ZachEnglish/KarisBox/KarisGiftPCB/KarisGiftPCB_Front.jpg

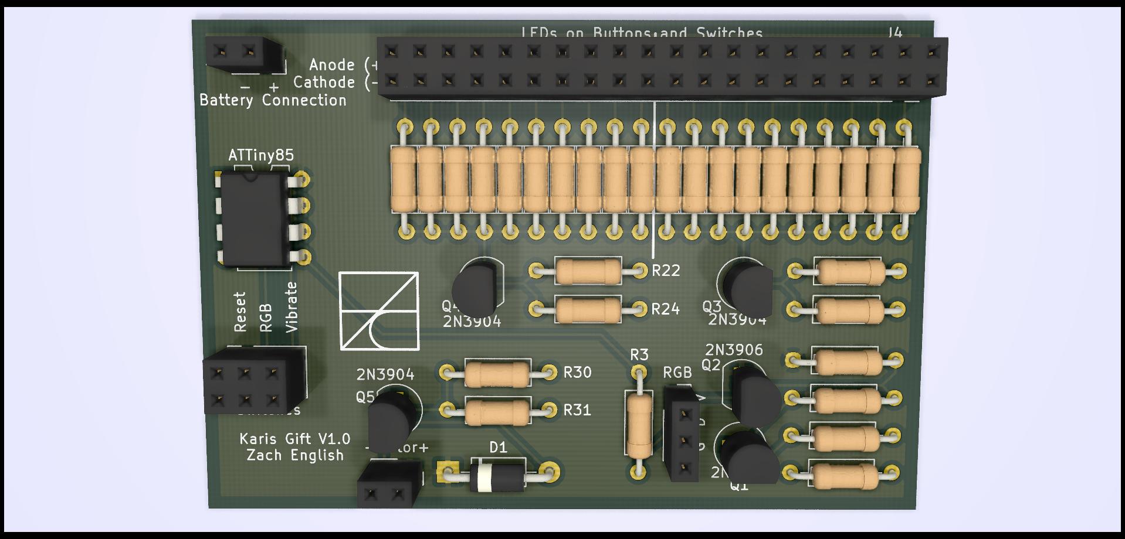
KarisGiftPCB/KarisGiftPCB_Front.jpg
