ZachEnglish/KarisBox/KarisGiftPCB/KarisGiftPCB_Back.jpg

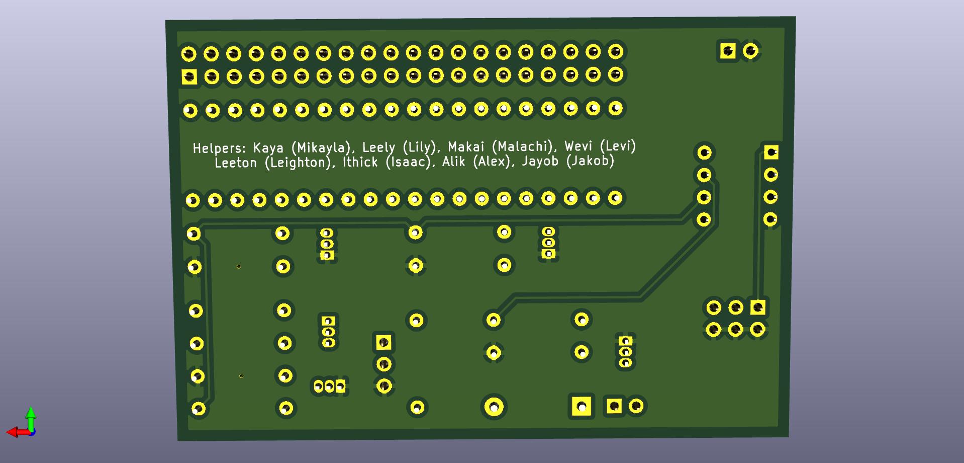
KarisGiftPCB/KarisGiftPCB_Back.jpg
