ZachEnglish/KarisBox/R_values_for_LEDs.docx

2.3k

420

420

2.0k

All at 3V without transistor drop.
