ZachEnglish/KarisBox/schematic.pdf

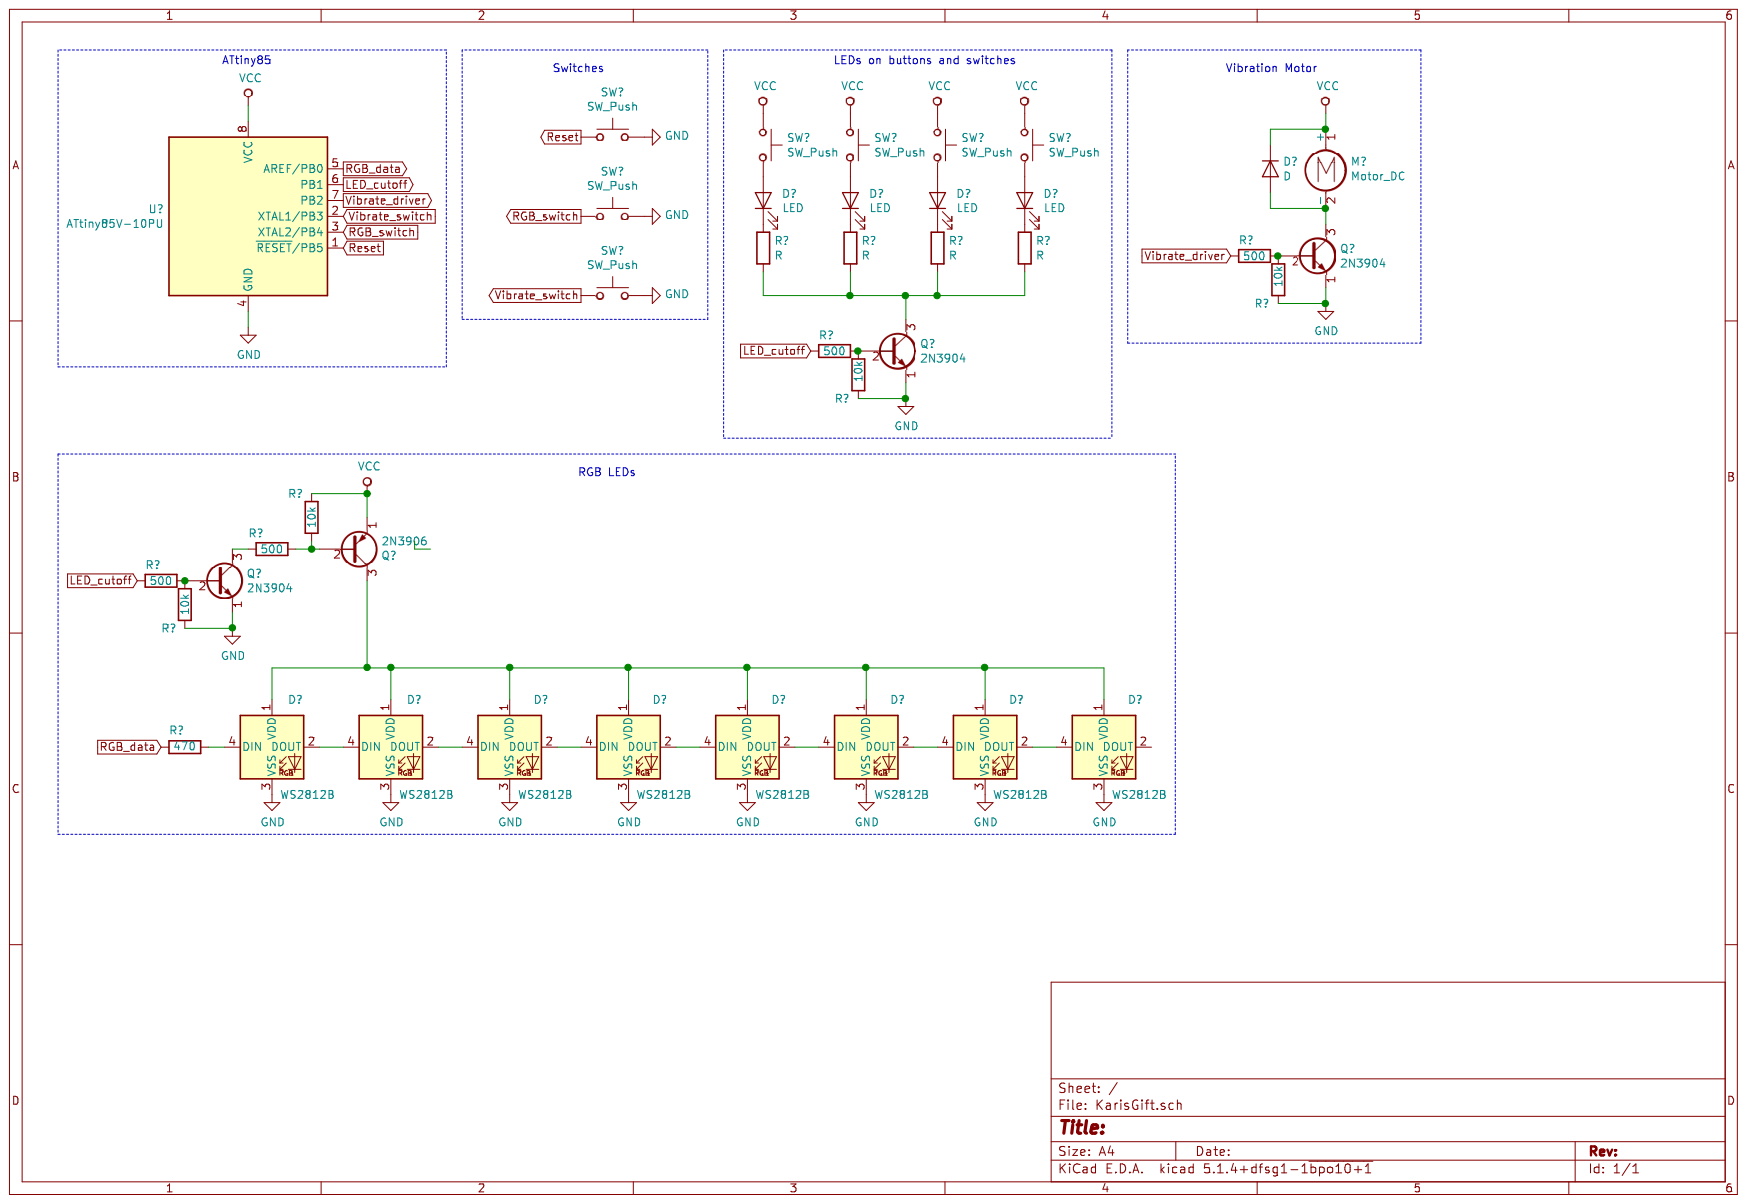
[picture p3: page 1]
