ZachEnglish/KarisBox/KarisGiftPCB/KarisGiftPCB_Schematic.pdf

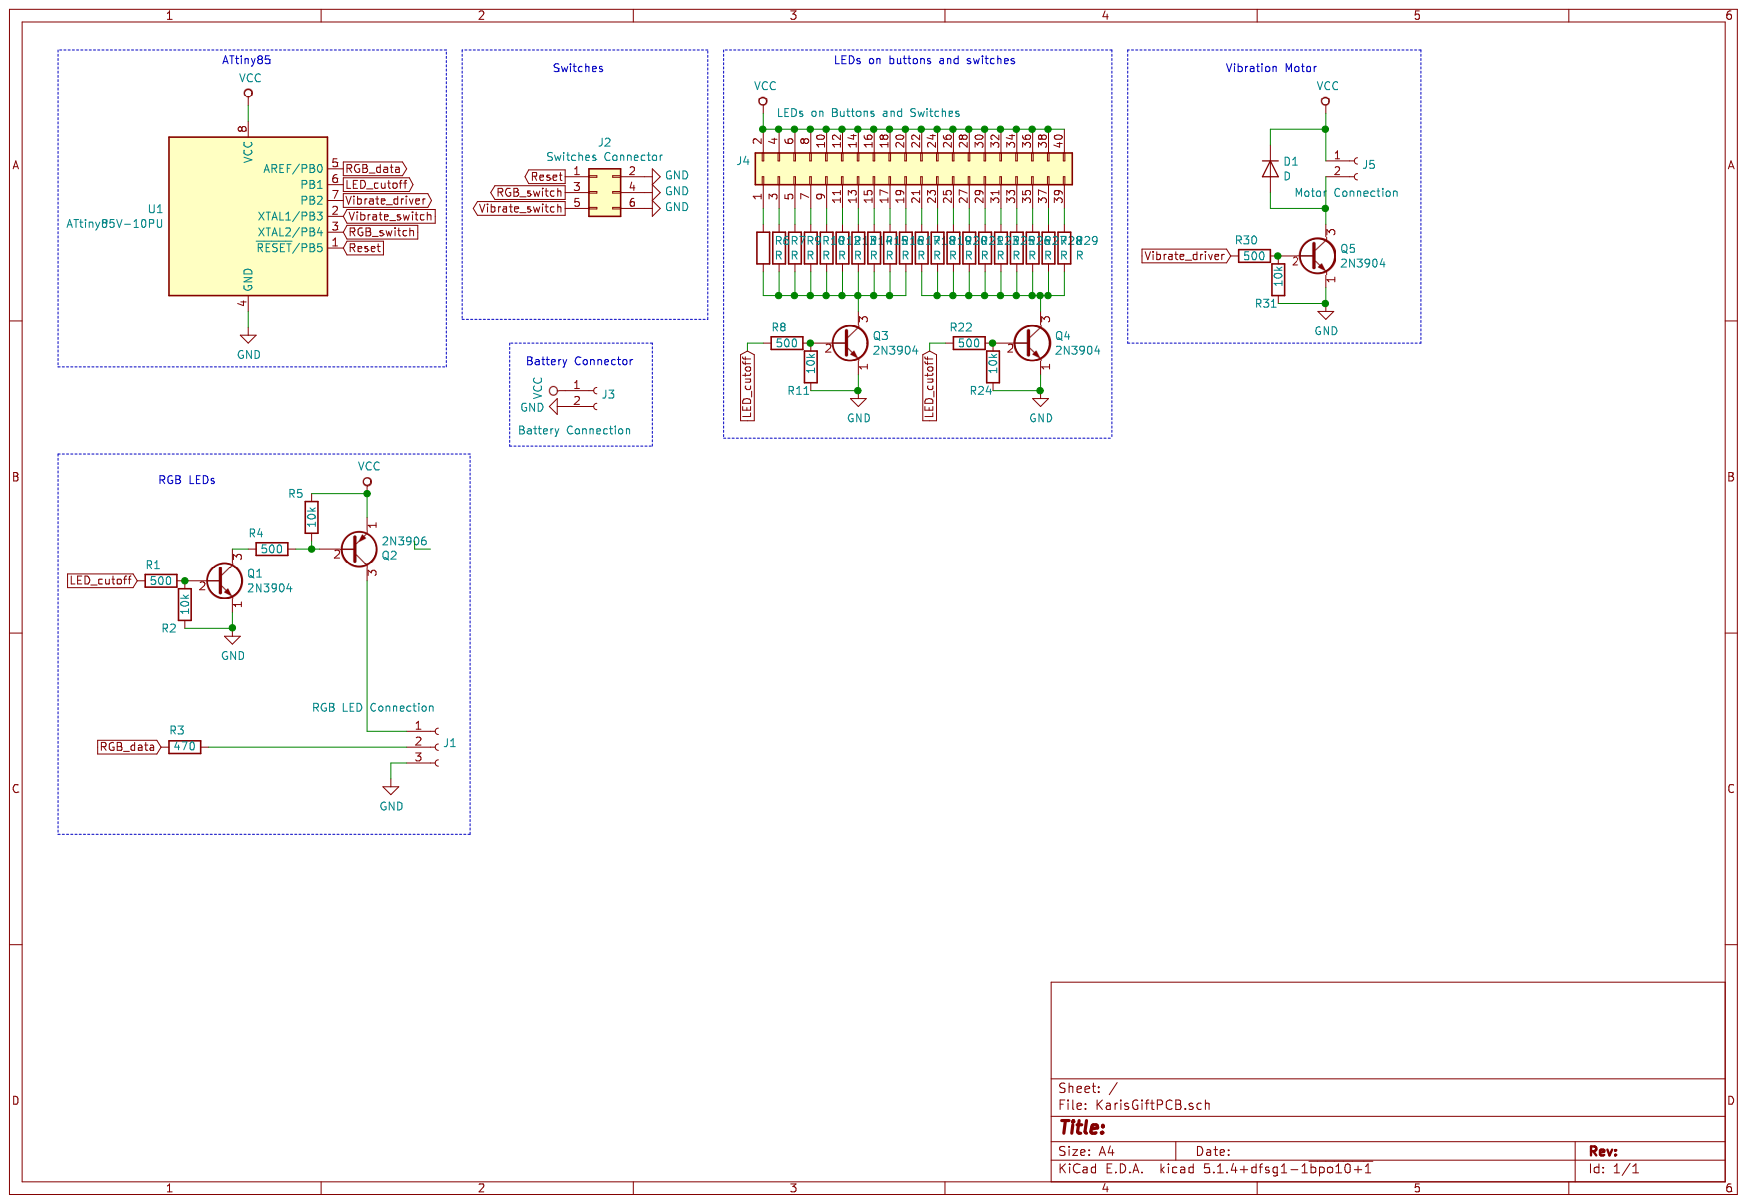
[picture p4: page 1]
