ZachEnglish/KarisBox/KarisGift.pdf

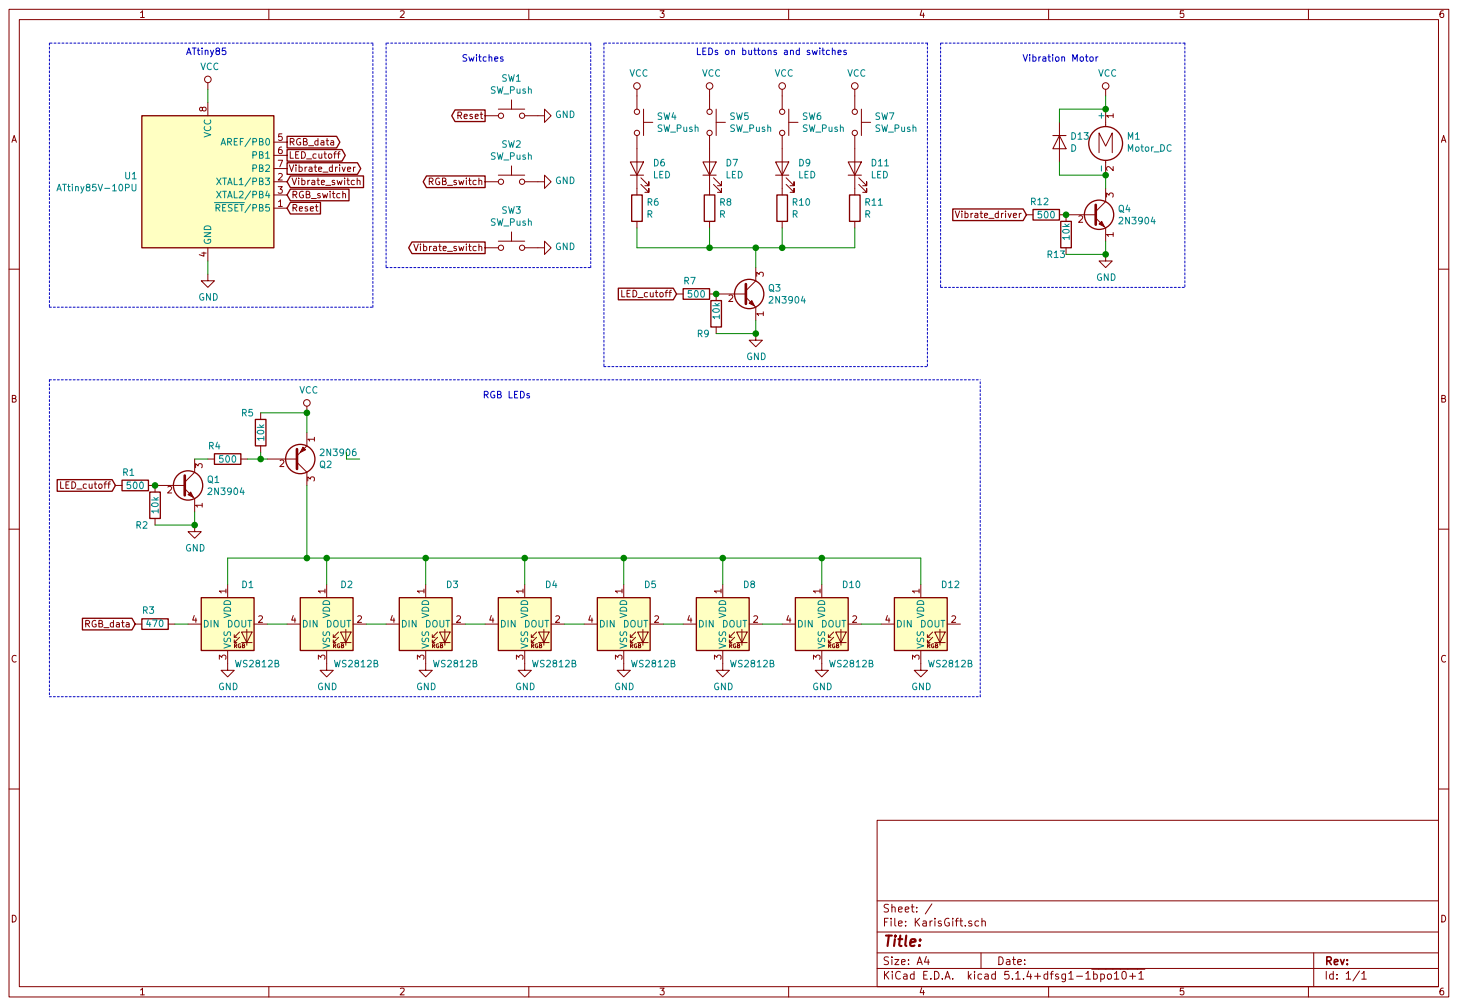
[picture p5: page 1]

Id: 1/1 Title: File: KarisGift.sch Sheet: /
