ZachEnglish/KarisBox/KarisGiftPCB/KarisGiftPCB.kicad_pcb

## KiCad design KarisGiftPCB/KarisGiftPCB.kicad_pcb (2021-02-07)

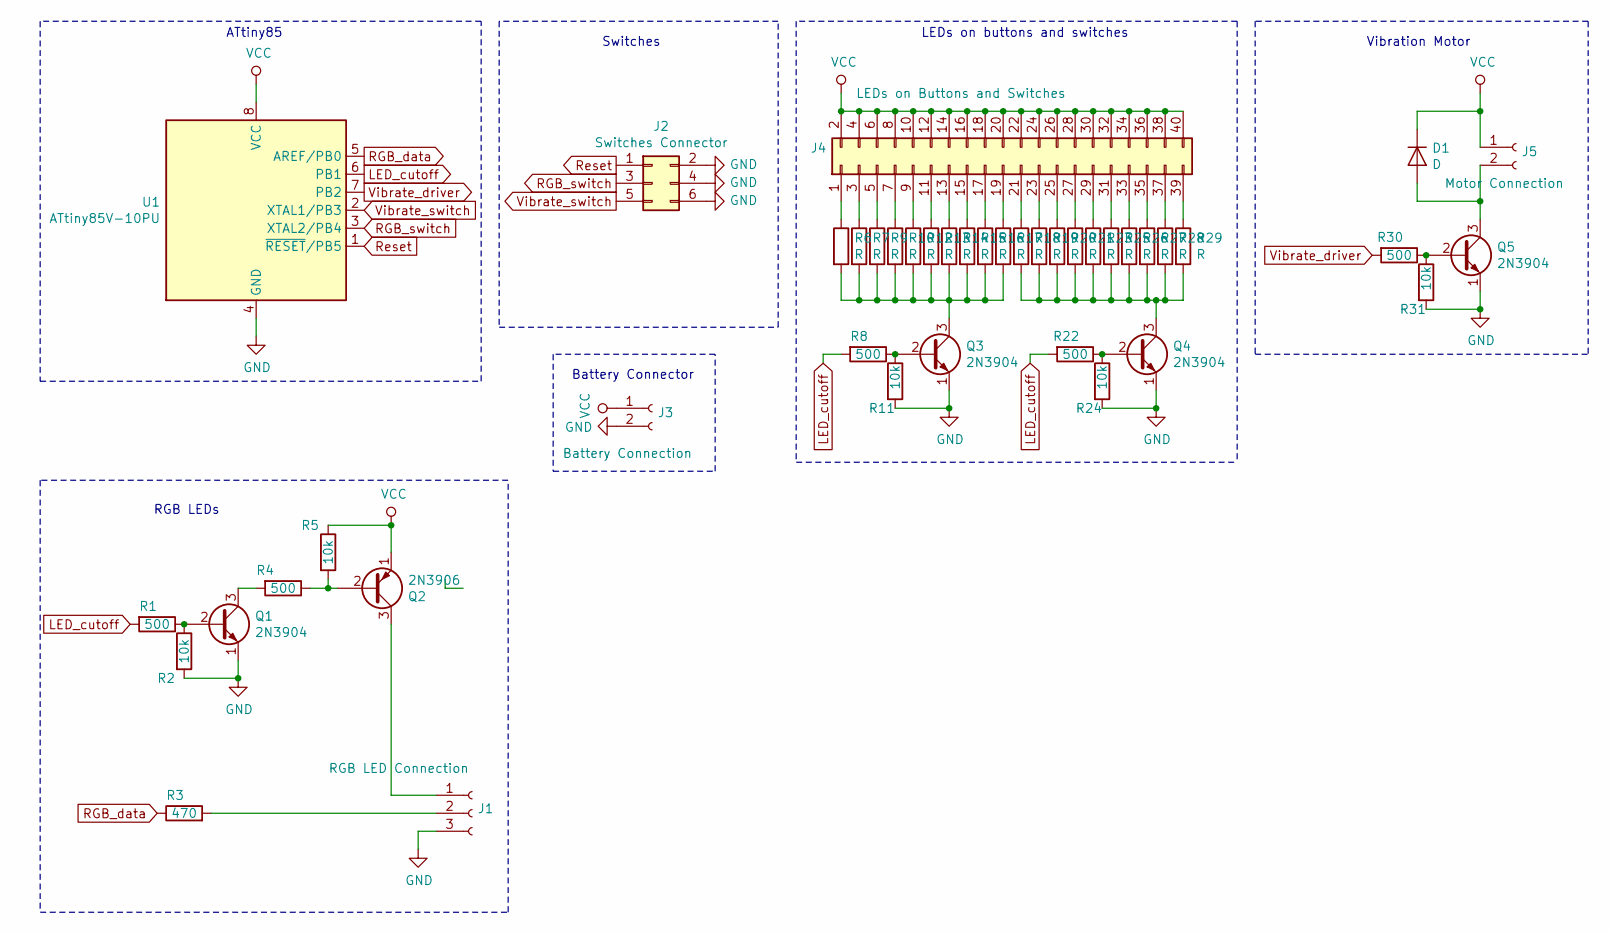
[picture p6: schematic KarisGiftPCB.sch]

Parts:
D1: D; D_DO-41_SOD81_P10.16mm_Horizontal
J1: RGB LED Connection; PinSocket_1x03_P2.54mm_Vertical
J2: Switches Connector; PinSocket_2x03_P2.54mm_Vertical
J3: Battery Connection; PinSocket_1x02_P2.54mm_Vertical
J4: LEDs on Buttons and Switches; PinSocket_2x20_P2.54mm_Vertical
J5: Motor Connection; PinSocket_1x02_P2.54mm_Vertical
Q1, Q3, Q4, Q5: 2N3904; TO-92_Inline
Q2: 2N3906; TO-92_Inline
R1, R4, R8, R22, R30: 500; R_Axial_DIN0207_L6.3mm_D2.5mm_P10.16mm_Horizontal
R2, R5, R11, R24, R31: 10k; R_Axial_DIN0207_L6.3mm_D2.5mm_P10.16mm_Horizontal
R3: 470; R_Axial_DIN0207_L6.3mm_D2.5mm_P10.16mm_Horizontal
R6, R7, R9, R10, R12, R13, R14, R15, R16, R17, R18, R19, R20, R21, R23, R25, R26, R27, R28, R29: R; R_Axial_DIN0207_L6.3mm_D2.5mm_P10.16mm_Horizontal
U1: ATtiny85V-10PU; DIP-8_W7.62mm

Connections:
GND: J1.3, J2.2, J2.4, J2.6, J3.2, Q1.1 (E), Q3.1 (E), Q4.1 (E), Q5.1 (E), R2.2, R11.2, R24.2, R31.2, U1.4 (GND); also elsewhere on the board
LED_cutoff: R1.2, R8.2, R22.2, U1.6 (PB1); also elsewhere on the board
unnamed 2: D1.2 (A), J5.2, Q5.3 (C); also elsewhere on the board
unnamed 3: J1.1, Q2.3 (C); also elsewhere on the board
unnamed 4: J1.2, R3.2; also elsewhere on the board
unnamed: J2.1, U1.1 (~RESET~/PB5)
unnamed: J2.3, U1.3 (XTAL2/PB4)
unnamed: J2.5, U1.2 (XTAL1/PB3)
unnamed: J4.1, R6.1
unnamed: J4.3, R7.1
unnamed: J4.5, R9.1
unnamed: J4.7, R10.1
unnamed: J4.9, R12.1
unnamed: J4.11, R13.1
unnamed: J4.13, R14.1
unnamed: J4.15, R15.1
unnamed: J4.17, R16.1
unnamed: J4.19, R17.1
unnamed: J4.21, R18.1
unnamed: J4.23, R19.1
unnamed: J4.25, R20.1
unnamed: J4.27, R21.1
unnamed: J4.29, R23.1
unnamed: J4.31, R25.1
unnamed: J4.33, R26.1
unnamed: J4.35, R27.1
unnamed: J4.37, R28.1
unnamed: J4.39, R29.1
unnamed: Q1.2 (B), R1.1, R2.1
unnamed: Q1.3 (C), R4.2
unnamed: Q2.2 (B), R4.1, R5.2
unnamed: Q3.2 (B), R8.1, R11.1
unnamed: Q3.3 (C), R6.2, R7.2, R9.2, R10.2, R12.2, R13.2, R14.2, R15.2, R16.2, R17.2
unnamed: Q4.2 (B), R22.1, R24.1
unnamed: Q4.3 (C), R18.2, R19.2, R20.2, R21.2, R23.2, R25.2, R26.2, R27.2, R28.2, R29.2
unnamed: Q5.2 (B), R30.1, R31.1
RGB_data: R3.1, U1.5 (AREF/PB0); also elsewhere on the board
VCC: D1.1 (K), J3.1, J4.2, J4.4, J4.6, J4.8, J4.10, J4.12, J4.14, J4.16, J4.18, J4.20, J4.22, J4.24, J4.26, J4.28, J4.30, J4.32, J4.34, J4.36, J4.38, J4.40, J5.1, Q2.1 (E), R5.1, U1.8 (VCC); also elsewhere on the board
Vibrate_driver: R30.2, U1.7 (PB2); also elsewhere on the board

Notes on the sheet:
ATtiny85
Switches
LEDs on buttons and switches
Vibration Motor
RGB LEDs
Battery Connector

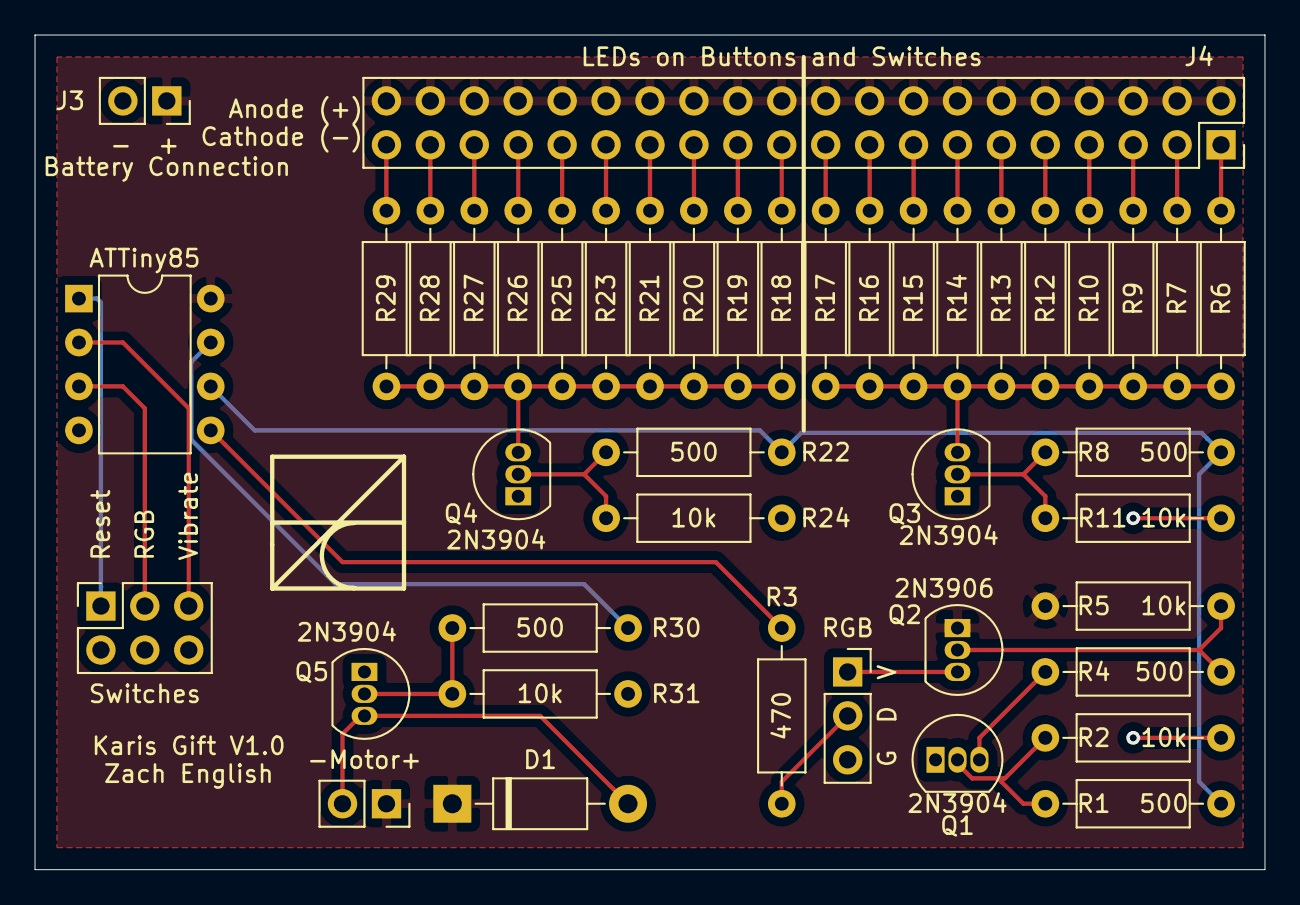
[picture p7: board KarisGiftPCB.kicad_pcb from above]

Board: 2 copper layers, 71.1 x 48.3 mm, 43 parts (0 on the bottom side), 39 nets.

Other parts of the board:
-Motor+: Motor Connection; PinSocket_1x02_P2.54mm_Vertical
ATTiny85: ATtiny85V-10PU; DIP-8_W7.62mm
RGB: RGB LED Connection; PinSocket_1x03_P2.54mm_Vertical
Switches: Switches; PinSocket_2x03_P2.54mm_Vertical

Their connections:
GND: ATTiny85.4, RGB.3, Switches.2, Switches.4, Switches.6; also elsewhere on the board
LED_cutoff: ATTiny85.6; also elsewhere on the board
unnamed 2: -Motor+.2; also elsewhere on the board
unnamed 3: RGB.1; also elsewhere on the board
unnamed 4: RGB.2; also elsewhere on the board
RGB_data: ATTiny85.5; also elsewhere on the board
RGB_switch: ATTiny85.3, Switches.3
Reset: ATTiny85.1, Switches.1
VCC: -Motor+.1, ATTiny85.8; also elsewhere on the board
Vibrate_driver: ATTiny85.7; also elsewhere on the board
Vibrate_switch: ATTiny85.2, Switches.5
