ZachEnglish/KarisBox/(commit log)

2021-01-08 Initial commit. Work in progress, need to update some transitors to PNP's.
    [KarisGift.kicad_pcb, KarisGift.sch]
2021-01-09 Updated RGB LEDs block to not move ground reference on data signal.
    Added pull up/down resisters for transistors.
    [KarisGift.sch]
2021-01-09 Added word file with R values for resistors.
2021-01-11 I can't believe it works! The code works!
    [KarisGift.sch]
2021-01-12 Updated schematic to use just one PNP transistor for RGB LEDs.
    Started the long process of cleaning up the code.
    [KarisGift.sch]
2021-01-12 Fixed backwards PNP transistor running the RGB LEDs (Thanks Ron!)
    Some more code cleanup.
    [KarisGift.sch]
2021-01-12 Mirrored PNP to make schematic less ugly
    [KarisGift.sch]
2021-01-13 Added second schematic in prep for layout. Replaced parts with jumpers.
    [KarisGiftPCB.sch]
2021-01-13 Added footprints to all parts in schematic.
    [KarisGift.sch, KarisGiftPCB.sch]
2021-01-13 Made new Kicad project for PCB schematic and layout. Started layout.
    [KarisGiftPCB.kicad_pcb, KarisGiftPCB.sch]
2021-01-13 Made some progress on PCB layout. "Some" as in, kinda started.
    [KarisGiftPCB.kicad_pcb, KarisGiftPCB.sch]
2021-01-14 Layout mostly done, just need wires, copper areas, and edge cuts.
    [KarisGiftPCB.kicad_pcb, KarisGiftPCB.sch]
2021-01-14 Finished board layout. Generated Gerber files.
    [KarisGiftPCB-B_Cu.gbr, KarisGiftPCB-B_Mask.gbr, KarisGiftPCB-B_SilkS.gbr, KarisGiftPCB-Edge_Cuts.gbr, KarisGiftPCB-F_Cu.gbr, KarisGiftPCB-F_Mask.gbr, KarisGiftPCB-F_SilkS.gbr, KarisGiftPCB.drl]
2021-01-14 Updated names for correctness and spelling.
    [KarisGiftPCB-B_Cu.gbr, KarisGiftPCB-B_Mask.gbr, KarisGiftPCB-B_SilkS.gbr, KarisGiftPCB-Edge_Cuts.gbr, KarisGiftPCB-F_Cu.gbr, KarisGiftPCB-F_Mask.gbr, KarisGiftPCB-F_SilkS.gbr, KarisGiftPCB.drl]
2021-01-15 Got the RGB states working! Stupid C standard and declaring variables in switch statements. Gah. Faught that quite a while.
    Still need to do more cleaning of code.
    Also, on the color wipes the RGB strip sometimes misses the first pixel
    on its first pass and catches it later. Not horrible, but catches your
    eye.
2021-01-15 Updated silkscreen and some code cleanup
    [KarisGiftPCB.kicad_pcb]
2021-01-16 Lot's of cleanup on code and one bug fix on the vibrate button logic.
    Untested in HW, but sure looks better in SW ;-)
    [KarisGiftCode.ino]
2021-01-18 It works! Tested on HW and it functions. Ran auto-format tool in Arduino
2021-02-07 Printed out again to submit for order
    [KarisGiftPCB-B_Cu.gbr, KarisGiftPCB-B_Mask.gbr, KarisGiftPCB-B_SilkS.gbr, KarisGiftPCB-Edge_Cuts.gbr, KarisGiftPCB-F_Cu.gbr, KarisGiftPCB-F_Mask.gbr, KarisGiftPCB-F_SilkS.gbr, KarisGiftPCB.drl]
2021-02-07 Now sketch saves state of current rgb mode to eeprom.
    Fixed bug where vibrate motor would always go off 30 seconds into sketch.
    Fixed minor naming inconsistancies.
    [KarisGiftCode.ino]
